Bart2000/StackCabinet/README.md

# StackCabinet
A modular component cabinet controlled by the touch of a finger
