Bart2000/StackCabinet/models/base/StackCabinet_Base_Main_Body_1X.3mf

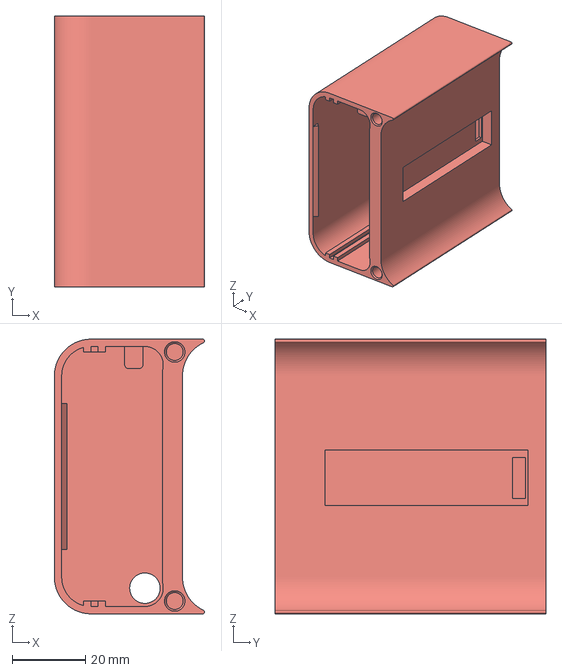
[picture p1: CAD file, 2023-01-27]
models/base/StackCabinet_Base_Main_Body_1X.3mf
41.0 x 74.0 x 75.0 mm
