Bart2000/StackCabinet/models/cabinet/StackCabinet_Main_Body_1X.3mf

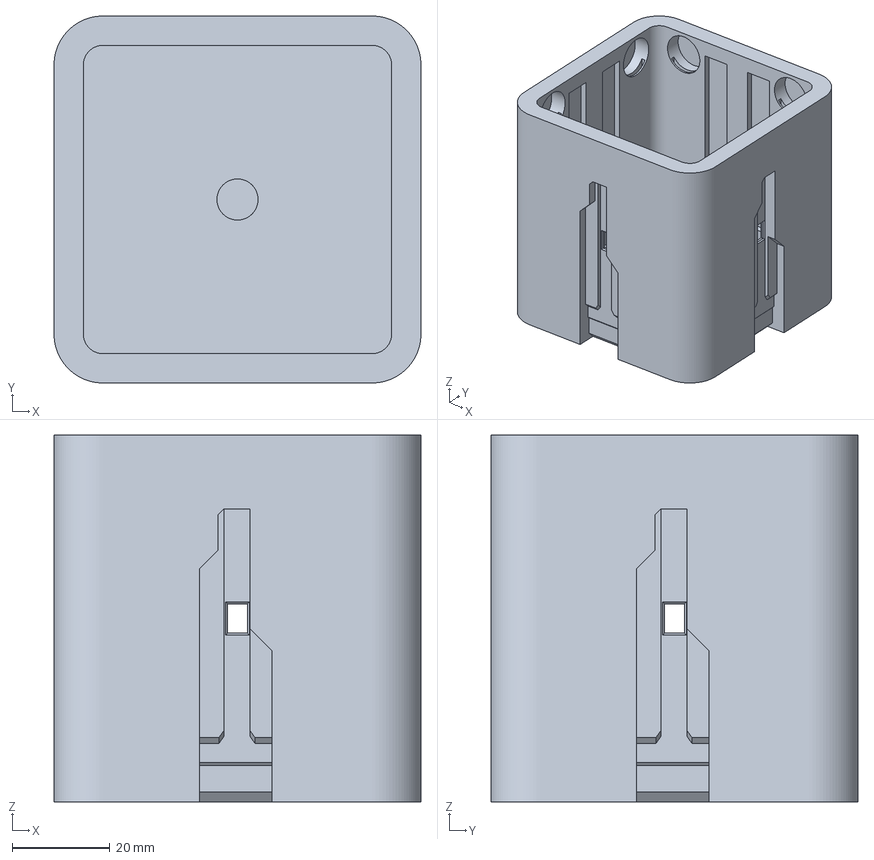
[picture p2: CAD file, 2023-01-27]
models/cabinet/StackCabinet_Main_Body_1X.3mf
75.0 x 75.0 x 75.0 mm
