Bart2000/StackCabinet/models/cabinet/StackCabinet_Main_Body_Hinge_Mount_1X.3mf

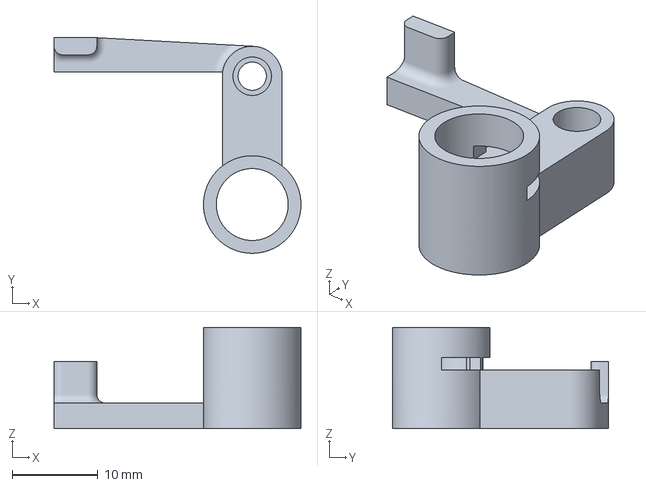
[picture p3: CAD file, 2023-01-23]
models/cabinet/StackCabinet_Main_Body_Hinge_Mount_1X.3mf
28.9 x 25.2 x 11.8 mm
