Bart2000/StackCabinet/models/base/StackCabinet_Base_Base_Magnet_retainer_2X.3mf

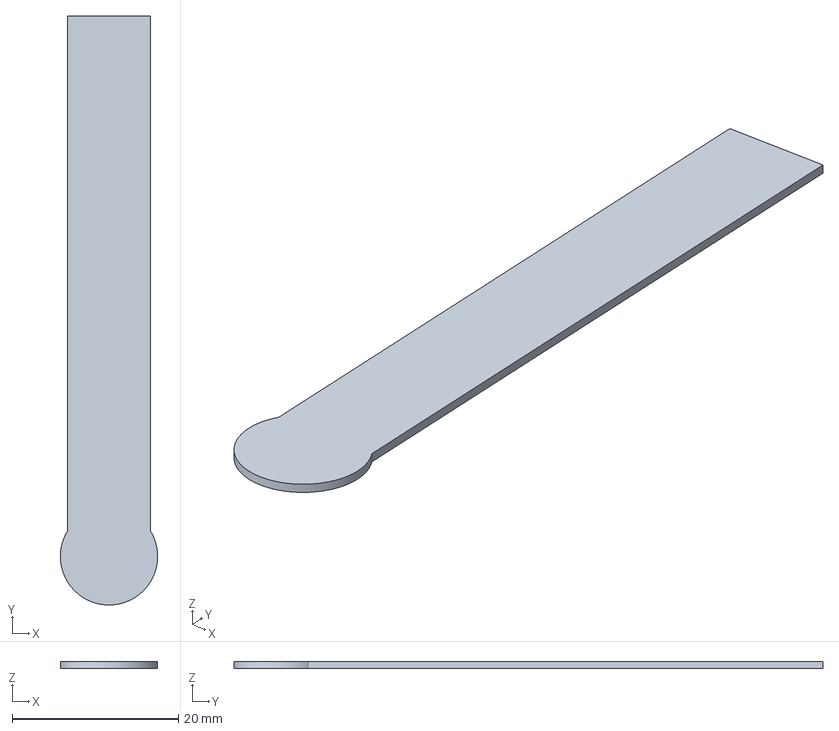
[picture p4: CAD file, 2023-01-23]
models/base/StackCabinet_Base_Base_Magnet_retainer_2X.3mf
11.7 x 70.8 x 0.8 mm
