Bart2000/StackCabinet/models/cabinet/StackCabinet_Magnet_Retainer_8X.3mf

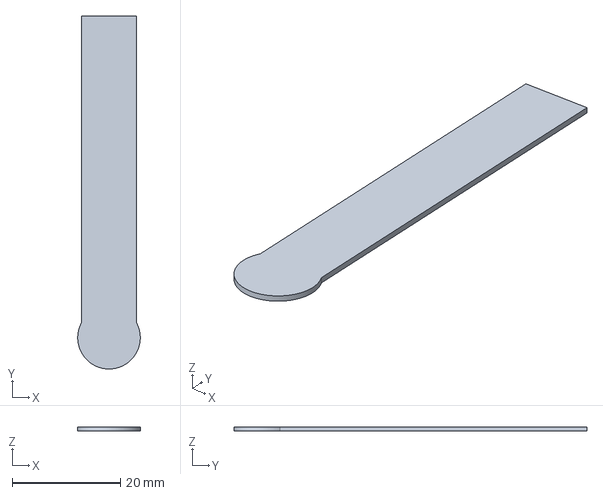
[picture p5: CAD file, 2023-01-23]
models/cabinet/StackCabinet_Magnet_Retainer_8X.3mf
11.6 x 65.3 x 0.8 mm
