Bart2000/StackCabinet/models/base/StackCabinet_Base_Lid_1X.3mf

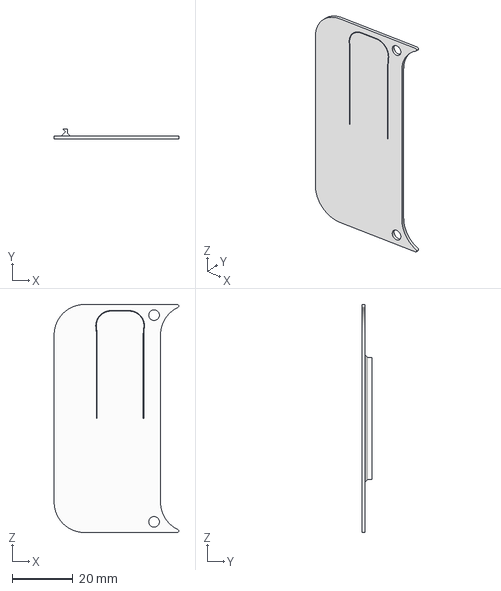
[picture p6: CAD file, 2023-01-23]
models/base/StackCabinet_Base_Lid_1X.3mf
41.0 x 3.39 x 75.0 mm
