Bart2000/StackCabinet/models/cabinet/StackCabinet_Drawer_P2_1X.3mf

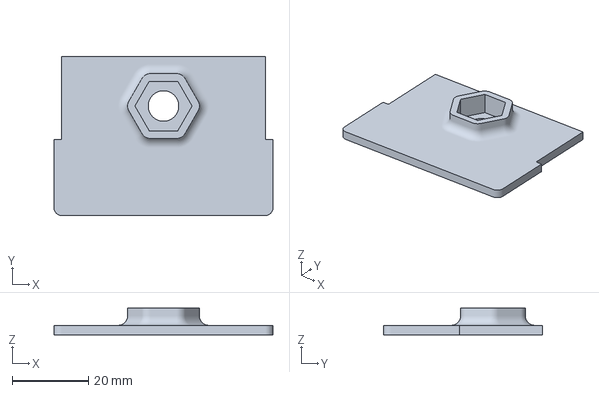
[picture p7: CAD file, 2023-01-23]
models/cabinet/StackCabinet_Drawer_P2_1X.3mf
57.5 x 41.8 x 7.00 mm
