Bart2000/StackCabinet/models/cabinet/StackCabinet_Drawer_P1_1X.3mf

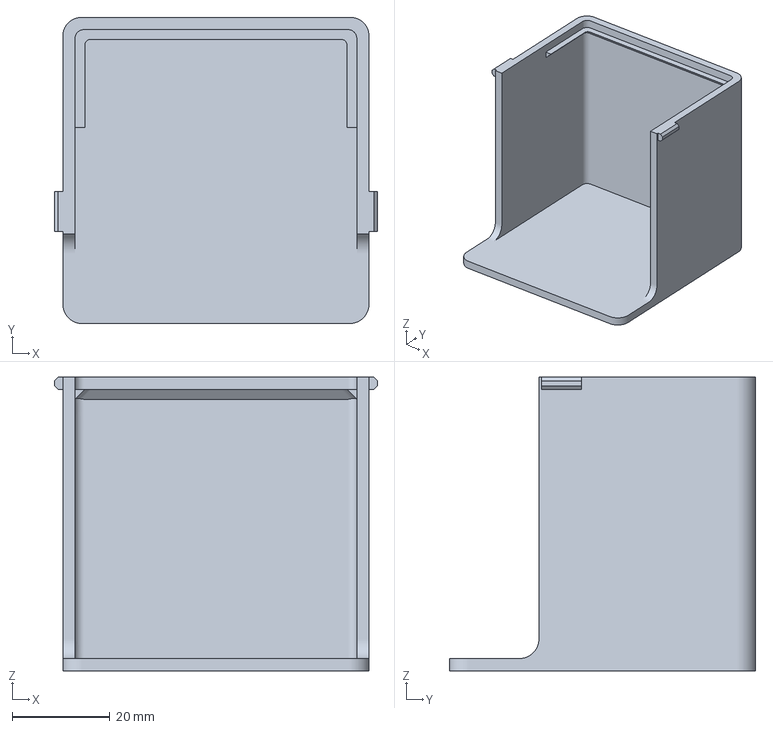
[picture p8: CAD file, 2023-01-23]
models/cabinet/StackCabinet_Drawer_P1_1X.3mf
66.0 x 62.6 x 60.0 mm
