Bart2000/StackCabinet/models/cabinet/StackCabinet_Backcover_1X.3mf

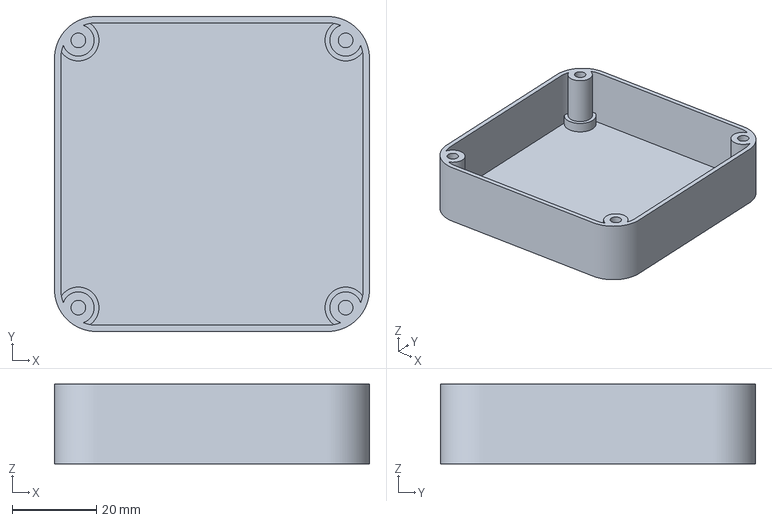
[picture p9: CAD file, 2023-01-23]
models/cabinet/StackCabinet_Backcover_1X.3mf
75.0 x 75.0 x 19.0 mm
