Bart2000/StackCabinet/models/cabinet/StackCabinet_Hinge_1X.3mf

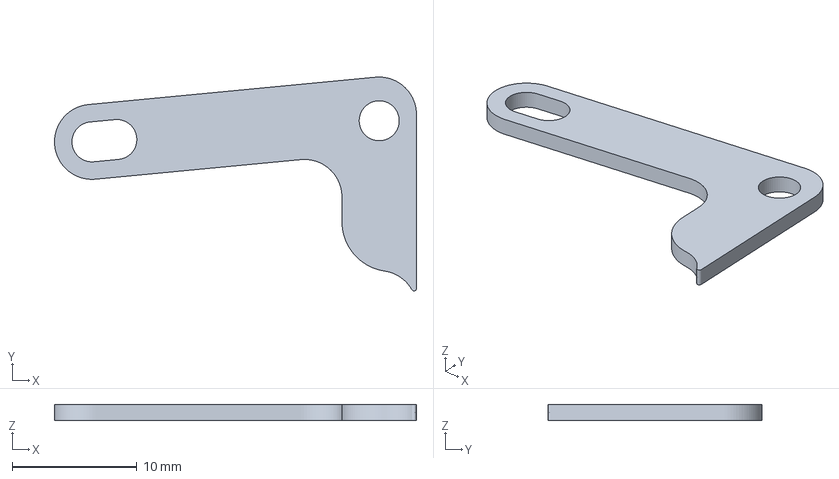
[picture p10: CAD file, 2023-01-23]
models/cabinet/StackCabinet_Hinge_1X.3mf
29.0 x 17.1 x 1.30 mm
