Bart2000/StackCabinet/(threads)

Thread 2 (2022-09-12):

SC_02 - As a user, I want to be able to connect the cabinet modulair

Krakert, 2022-09-12:
**DoD**
- [ ] Search for suitable spring fingers/contacts that we can use to develop a custom connector.
- [ ] Develop a small and simple PCB where the spring fingers/contacts can be mounted to.
- [ ] Develop a mating case where the PCB will sit in and be able to connect properly.

Thread 3 (2022-09-12):

SC_03 - As a developer, I want a prototyping PCB that demonstrates all the functionalities of the Cabinet PCB

Bart2000, 2022-09-12:
**DoD**
Making 3 individual prototyping PCBs to test all the complex hardware before making a final order.

- [x] Controls to actuate the solenoid
- [x] Switching regulator to step down the voltage to 24V and 5V
- [x] Transistor array for controlling the 12 LEDs

Krakert, 2022-09-29:
**Step Down Regulator**

* **Step-Down Voltage Regulator 48V -> 24V @ 1A (solenoid)**
   -  LM2576HVT - ADJ
* **Step-Down Voltage Regulator 24V -> 5V @ 1A (main electronic)**
(High voltage (> 40V) Step-Down Regulator are not commanly aviable, that why we will transform the 24V to 5V)
   - XL1509-5.0E1

Closed 2023-01-18.

Thread 6 (2022-10-12):

SC_06 - As a developer, I want to have a first cabinet PCB design done and orderd

Krakert, 2022-10-12:
**DoD**
- [x] Calculations done for step-down converters
- [x] Schematic
- [x] 2 layer PCB design that fits cabinet
- [x] Ordered (on completion of #3 )

Krakert, 2022-12-01:
@Bart2000 We can close this one, PCB's are ordered.

Closed 2023-01-18.

Thread 8 (2022-10-12):

SC_08 - As a user, I want to have an app that interfaces with the StackCabinet

Krakert, 2022-10-12:
**DoD**
- [x] Look into setting up a Bluetooth connection with Android devices and the ESP32
- [x] Build structure for the app
- [x] Setup code to connect to a ESP32
- [x] Send example data to and from the ESP

Krakert, 2022-12-01:
@Bart2000 I think, that we can close this issue, progress is going well with the app

Closed 2022-12-07.

Thread 11 (2022-12-12):

SC_09 - As a developer, I want to have a PCB for the base controller

Bart2000, 2022-12-12:
DoD:

- [x] PCB contains step down from 36V to 5V
- [x] PCB contains open drain circuit for half duplex communication
- [x] PCB contains level shifter for communication between 3.3V and 5V
- [x] PCB contains SCCP connector compliance

Closed 2023-01-23.

Thread 21 (2023-01-11):

SC_17 - As a user, I want to be able to search for a component in the app

Krakert, 2023-01-11:
DoD:

- [ ] Search button to start a search
- [ ] highlight the cabinet that contains the correct component
