Bart2000/StackCabinet/boards/base/base.kicad_pcb

## KiCad design boards/base/base.kicad_pcb (2023-01-23)

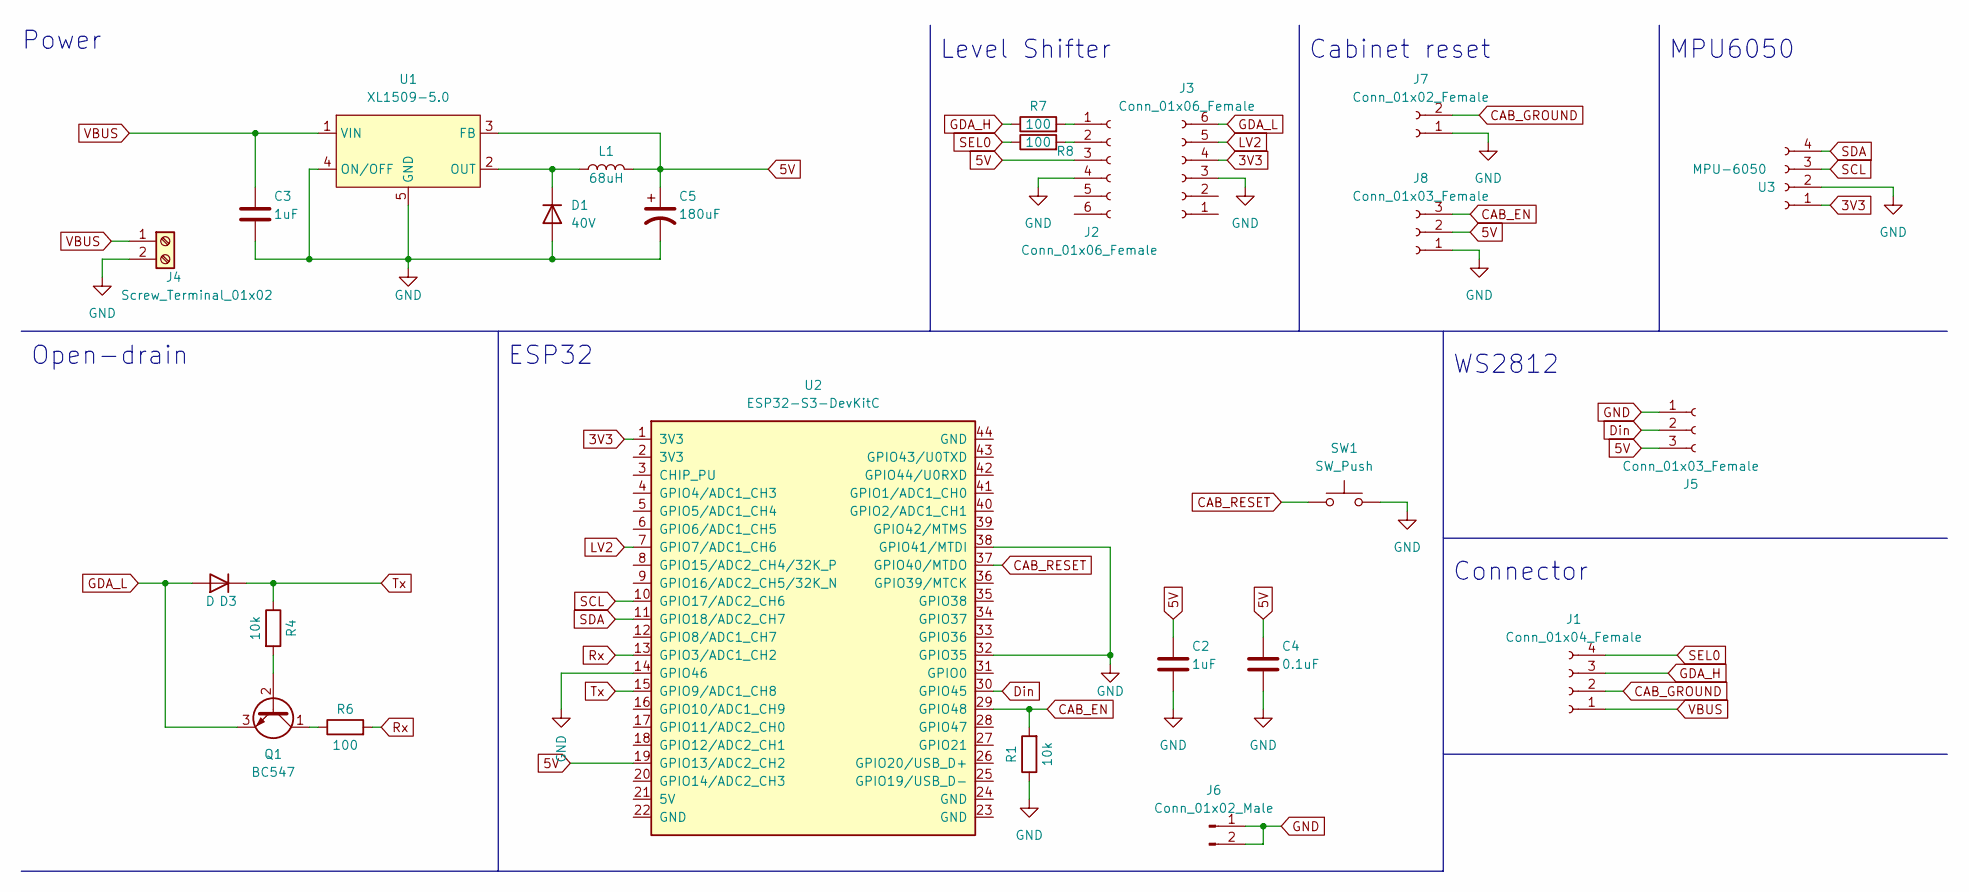
[picture p11: schematic base.kicad_sch]

Parts:
C2, C3: 1uF; C_0805_2012Metric; Mfr. Part# CC0805KKX7R9BB105; LCSC. Part# C91185
C4: 0.1uF; C_0805_2012Metric; Mfr. Part# C0805B104K500NT; LCSC. Part# C476766
C5: 180uF; CP_Radial_D8.0mm_P3.50mm; Mfr. Part# LKMD0901V181MF; LCSC. Part# C442870
D1: 40V; D_SOD-123; Mfr. Part# DSK34; LCSC. Part# C3015221
D3: D; R_Box_L8.4mm_W2.5mm_P5.08mm
J1: Conn_01x04_Female; PinHeader_1x04_P2.54mm_Vertical
J2, J3: Conn_01x06_Female; PinHeader_1x06_P2.54mm_Vertical
J4: Screw_Terminal_01x02; Altech_AK300_1x02_P5.00mm_45-Degree
J5, J8: Conn_01x03_Female; PinHeader_1x03_P2.54mm_Vertical
J6: Conn_01x02_Male; TerminalBlock_Altech_AK300-2_P5.00mm
J7: Conn_01x02_Female; Altech_AK300_1x02_P5.00mm_45-Degree
L1: 68uH; L_6.3x6.3_H3; Mfr. Part# CYA0650-68UH; LCSC. Part# C5189964
Q1: BC547; TO-92_Inline
R1, R4: 10k; R_Axial_DIN0207_L6.3mm_D2.5mm_P5.08mm_Vertical
R6, R7, R8: 100; R_Axial_DIN0207_L6.3mm_D2.5mm_P5.08mm_Vertical
SW1: SW_Push; PinHeader_1x02_P2.54mm_Vertical
U1: XL1509-5.0; XLE1509; Mfr. Part# XL1509-5.0E1; LCSC. Part# C61063
U2: ESP32-S3-DevKitC; ESP32-DevKitC
U3: MPU-6050; PinHeader_1x04_P2.54mm_Vertical

Connections:
3V3: J3.4, U2.1 (3V3), U3.1
5V: C2.1, C4.1, C5.1, J2.3, J5.3, J8.2, L1.2, U1.3 (FB), U2.19 (GPIO13/ADC2_CH2)
CAB_EN: J8.3, R1.2, U2.29 (GPIO48)
CAB_GROUND: J1.2, J7.2
CAB_RESET: SW1.1, U2.37 (GPIO40/MTDO)
Din: J5.2, U2.30 (GPIO45)
GDA_H: J1.3, R7.1
GDA_L: D3.2 (A), J3.6, Q1.3 (E)
GND: C2.2, C3.2, C4.2, C5.2, D1.2 (A), J2.4, J3.3, J4.2, J5.1, J6.1, J6.2, J7.1, J8.1, R1.1, SW1.2, U1.4 (ON/OFF), U1.5 (GND), U2.14 (GPIO46), U2.32 (GPIO35), U2.38 (GPIO41/MTDI), U3.2
LV2: J3.5, U2.7 (GPIO7/ADC1_CH6)
unnamed: D1.1 (K), L1.1, U1.2 (OUT)
unnamed: J2.1, R7.2
unnamed: J2.2, R8.2
unnamed: Q1.1 (C), R6.1
unnamed: Q1.2 (B), R4.2
Rx: R6.2, U2.13 (GPIO3/ADC1_CH2)
SCL: U2.10 (GPIO17/ADC2_CH6), U3.3
SDA: U2.11 (GPIO18/ADC2_CH7), U3.4
SEL0: J1.4, R8.1
Tx: D3.1 (K), R4.1, U2.15 (GPIO9/ADC1_CH8)
VBUS: C3.1, J1.1, J4.1, U1.1 (VIN)

Notes on the sheet:
ESP32
WS2812
Power
Open-drain
Level Shifter
Connector
Cabinet reset
MPU6050

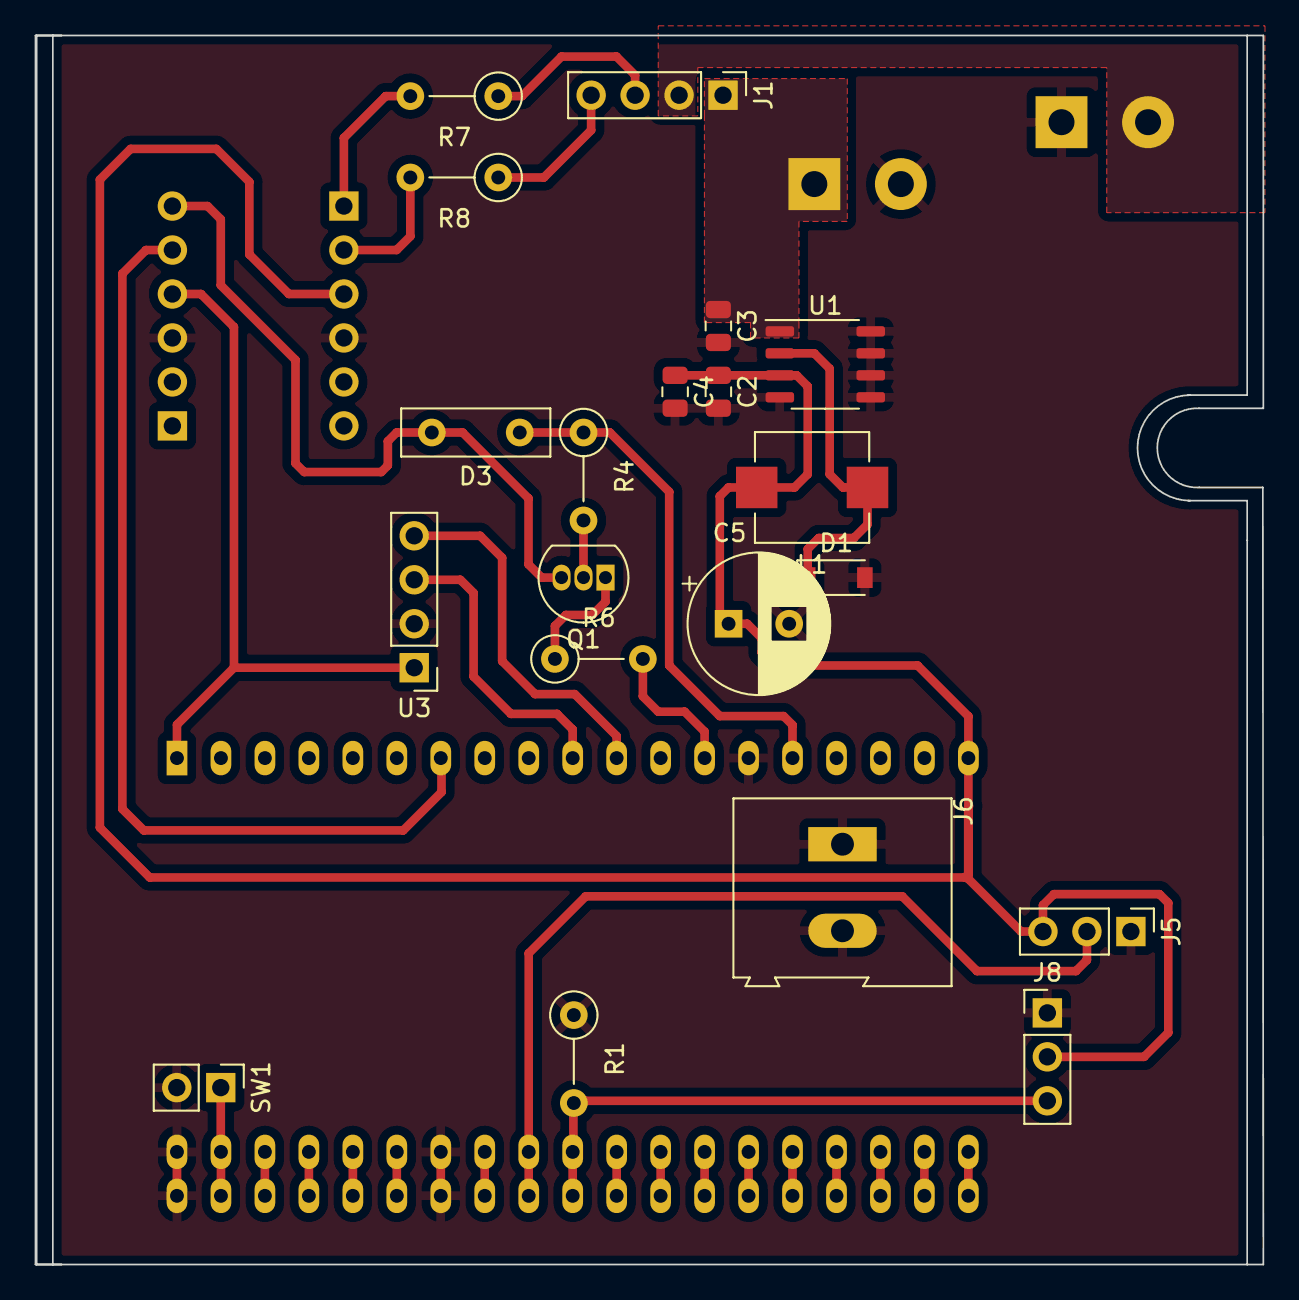
[picture p12: board base.kicad_pcb from above]

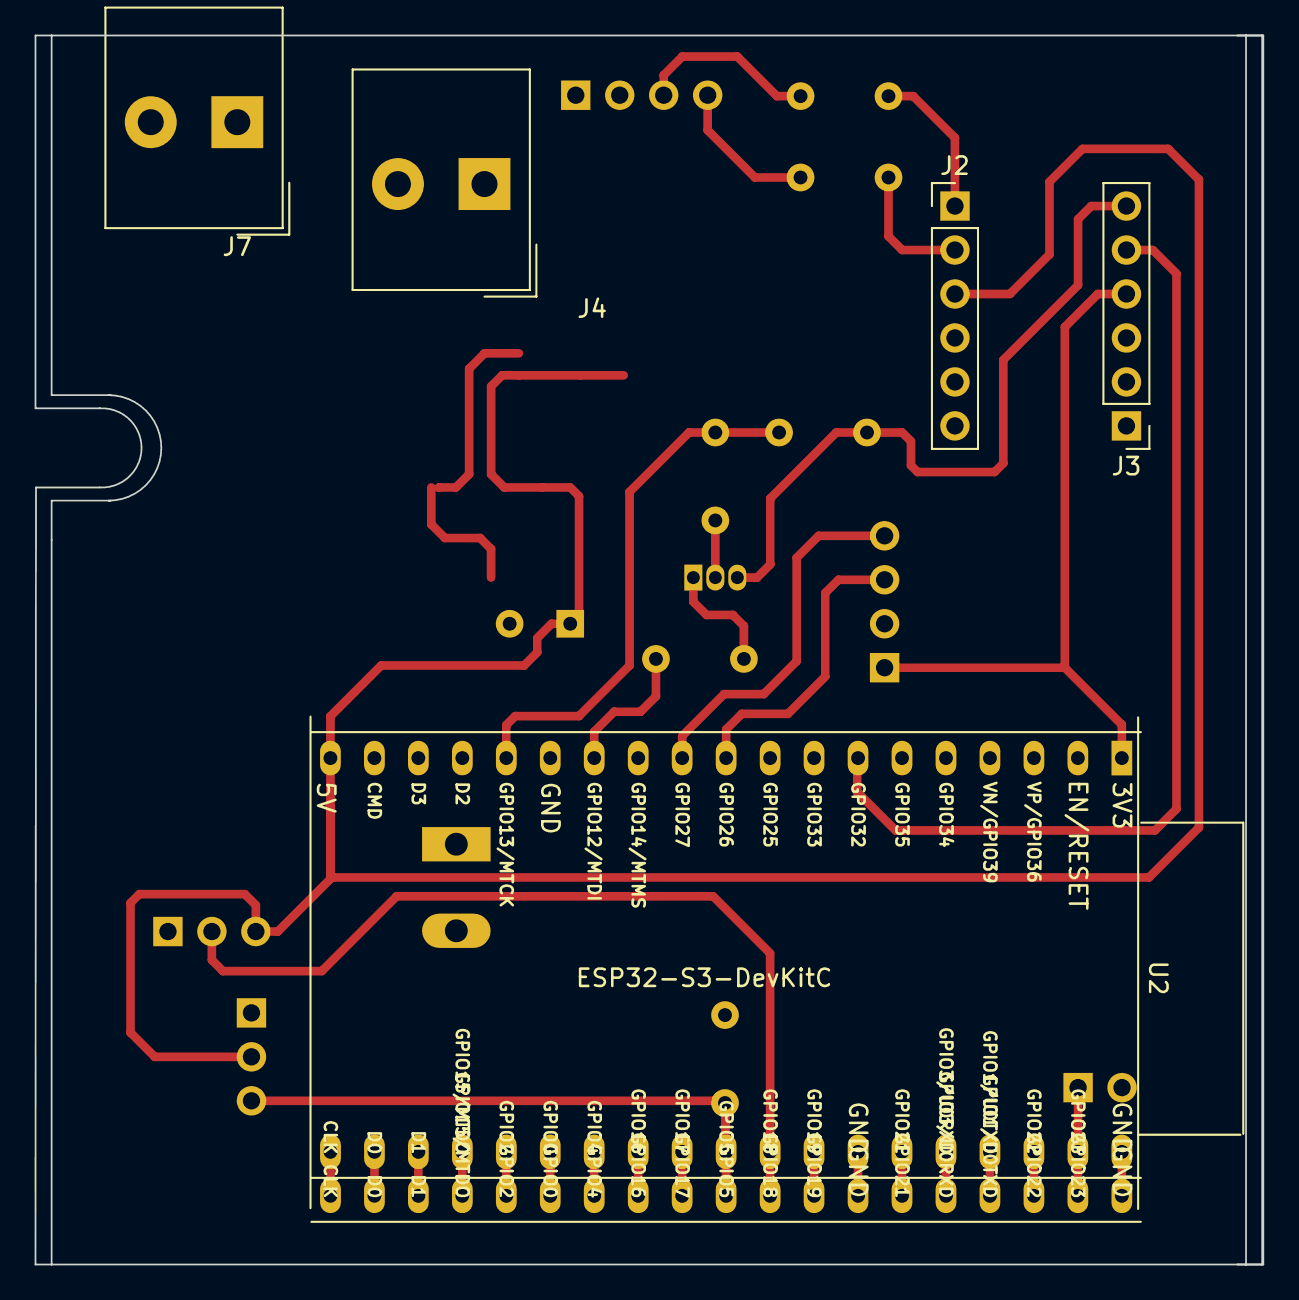
[picture p13: board base.kicad_pcb from below]

Board: 2 copper layers, 70.9 x 71.0 mm, 25 parts (5 on the bottom side), 21 nets.
