Bart2000/StackCabinet/boards/cab/cab.kicad_pcb

## KiCad design boards/cab/cab.kicad_pcb (2023-01-23)

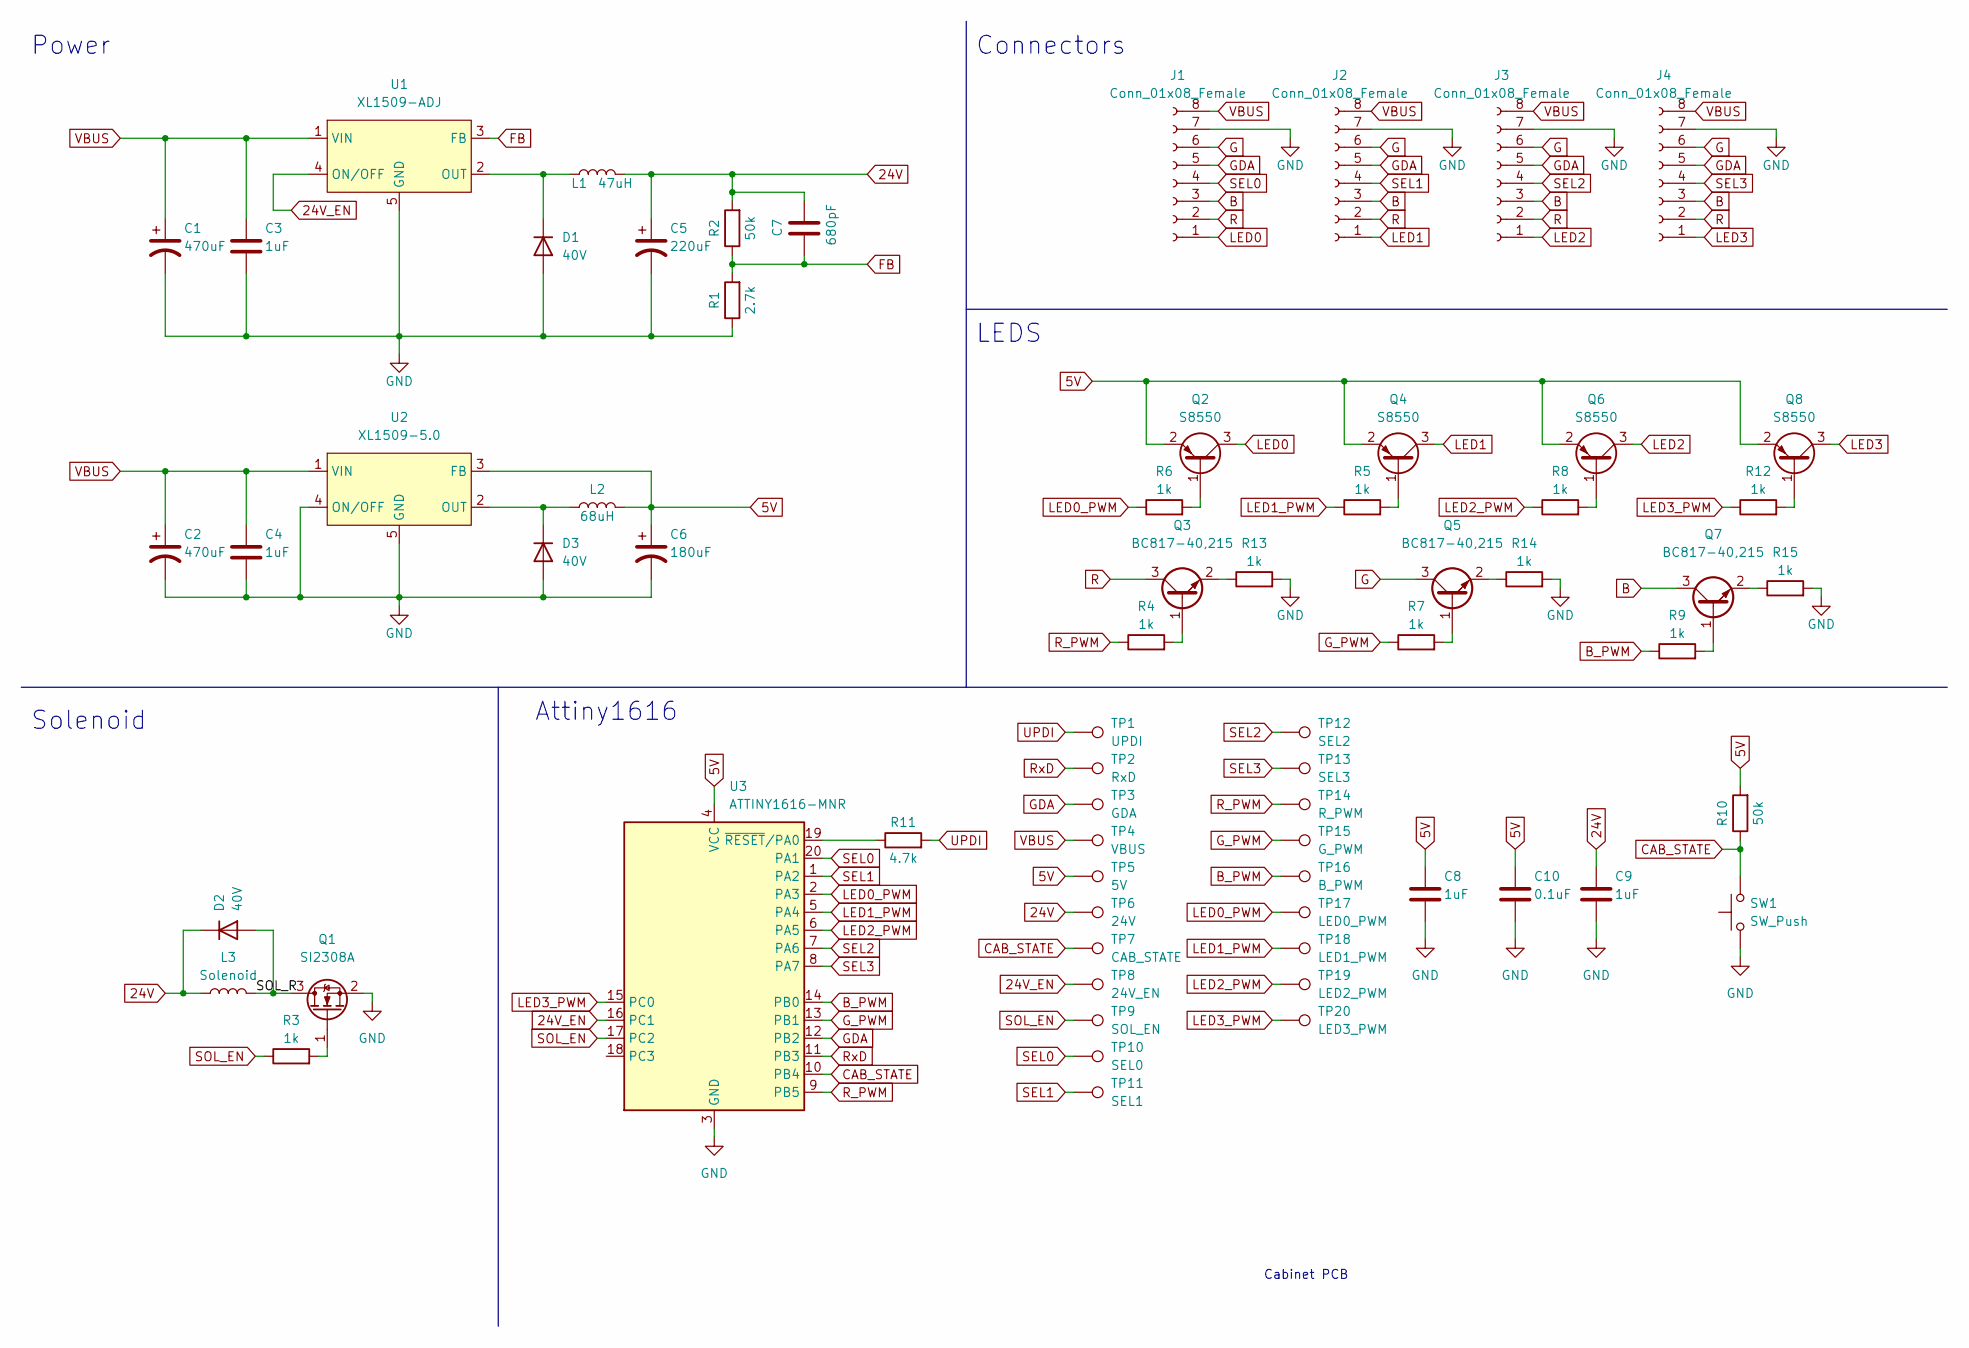
[picture p14: schematic cab.kicad_sch]

Parts:
C1, C2: 470uF; C_Radial_D12.5mm_H20.0mm_P5.00mm; Mfr. Part# OGPL41H471MF; LCSC. Part# C269945
C3, C4, C8, C9: 1uF; C_0805_2012Metric; Mfr. Part# CC0805KKX7R9BB105; LCSC. Part# C91185
C5: 220uF; CP_Radial_D8.0mm_P3.50mm; Mfr. Part# ECR1VBK221MLL080011; LCSC. Part# C221302
C6: 180uF; CP_Radial_D8.0mm_P3.50mm; Mfr. Part# LKMD0901V181MF; LCSC. Part# C442870
C7: 680pF; C_0805_2012Metric; Mfr. Part# 0805B681K500CT; LCSC. Part# C152864
C10: 0.1uF; C_0805_2012Metric; Mfr. Part# C0805B104K500NT; LCSC. Part# C476766
D1, D2, D3: 40V; D_SOD-123; Mfr. Part# DSK34; LCSC. Part# C3015221
J1, J2, J3, J4: Conn_01x08_Female; PinHeader_1x08_P1.27mm_Vertical; Mfr. Part# C691120; LCSC. Part# C691120
L1: 47uH; YNR1050-470M; Mfr. Part# YNR1050-470M; LCSC. Part# C5142143
L2: 68uH; L_6.3x6.3_H3; Mfr. Part# CYA0650-68UH; LCSC. Part# C5189964
L3: Solenoid; TerminalBlock_4Ucon_1x02_P3.50mm_Vertical; Mfr. Part# KF350-3.5-2P; LCSC. Part# C474892
Q1: SI2308A; SOT-23; Mfr. Part# SI2308A; LCSC. Part# C347491
Q2, Q4, Q6, Q8: S8550; SOT-23; Mfr. Part# S8550; LCSC. Part# C181159
Q3, Q5, Q7: BC817-40,215; SOT-23; Mfr. Part# BC817-40,215; LCSC. Part# C52801
R1: 2.7k; R_0805_2012Metric; Mfr. Part# ARG05FTC2701; LCSC. Part# C218493
R2, R10: 50k; R_0805_2012Metric; Mfr. Part# ARG05DTC5002; LCSC. Part# C2828840
R3, R4, R5, R6, R7, R8, R9, R12, R13, R14, R15: 1k; R_0805_2012Metric; Mfr. Part# SWR05JTEV1001; LCSC. Part# C412430
R11: 4.7k; R_0805_2012Metric; Mfr. Part# RS-05K472JT; LCSC. Part# C115310
SW1: SW_Push; PinHeader_1x02_P2.54mm_Vertical; Mfr. Part# B3F-1005; LCSC. Part# C397293
TP1: UPDI; testpad
TP2: RxD; testpad
TP3: GDA; testpad
TP4: VBUS; testpad
TP5: 5V; testpad
TP6: 24V; testpad
TP7: CAB_STATE; testpad
TP8: 24V_EN; testpad
TP9: SOL_EN; testpad
TP10: SEL0; testpad
TP11: SEL1; testpad
TP12: SEL2; testpad
TP13: SEL3; testpad
TP14: R_PWM; testpad
TP15: G_PWM; testpad
TP16: B_PWM; testpad
TP17: LED0_PWM; testpad
TP18: LED1_PWM; testpad
TP19: LED2_PWM; testpad
TP20: LED3_PWM; testpad
U1: XL1509-ADJ; XLE1509; Mfr. Part# XL1509-ADJE1; LCSC. Part# C74192
U2: XL1509-5.0; XLE1509; Mfr. Part# XL1509-5.0E1; LCSC. Part# C61063
U3: ATTINY1616-MNR; VQFN-20-1EP_3x3mm_P0.4mm_EP1.7x1.7mm; Mfr. Part# ATTINY1616-MNR; LCSC. Part# C507118

Connections:
5V: C6.1, C8.1, C10.1, L2.2, Q2.2 (E), Q4.2 (E), Q6.2 (E), Q8.2 (E), R10.2, TP5.1, U2.3 (FB), U3.4 (VCC)
24V: C5.1, C7.1, C9.1, D2.1 (K), L1.2, L3.1, R2.2, TP6.1
24V_EN: TP8.1, U1.4 (ON/OFF), U3.16 (PC1)
/SOL_R: D2.2 (A), L3.2, Q1.3 (D)
B: J1.3, J2.3, J3.3, J4.3, Q7.3 (C)
B_PWM: R9.1, TP16.1, U3.14 (PB0)
CAB_STATE: R10.1, SW1.2, TP7.1, U3.10 (PB4)
FB: C7.2, R1.2, R2.1, U1.3 (FB)
G: J1.6, J2.6, J3.6, J4.6, Q5.3 (C)
GDA: J1.5, J2.5, J3.5, J4.5, TP3.1, U3.12 (PB2)
GND: C1.2, C2.2, C3.2, C4.2, C5.2, C6.2, C8.2, C9.2, C10.2, D1.2 (A), D3.2 (A), J1.7, J2.7, J3.7, J4.7, Q1.2 (S), R1.1, R13.2, R14.2, R15.2, SW1.1, U1.5 (GND), U2.4 (ON/OFF), U2.5 (GND), U3.3 (GND), U3.21 (GND)
G_PWM: R7.1, TP15.1, U3.13 (PB1)
LED0: J1.1, Q2.3 (C)
LED0_PWM: R6.1, TP17.1, U3.2 (PA3)
LED1: J2.1, Q4.3 (C)
LED1_PWM: R5.1, TP18.1, U3.5 (PA4)
LED2: J3.1, Q6.3 (C)
LED2_PWM: R8.1, TP19.1, U3.6 (PA5)
LED3: J4.1, Q8.3 (C)
LED3_PWM: R12.1, TP20.1, U3.15 (PC0)
unnamed: D1.1 (K), L1.1, U1.2 (OUT)
unnamed: D3.1 (K), L2.1, U2.2 (OUT)
unnamed: Q1.1 (G), R3.2
unnamed: Q2.1 (B), R6.2
unnamed: Q3.1 (B), R4.2
unnamed: Q3.2 (E), R13.1
unnamed: Q4.1 (B), R5.2
unnamed: Q5.1 (B), R7.2
unnamed: Q5.2 (E), R14.1
unnamed: Q6.1 (B), R8.2
unnamed: Q7.1 (B), R9.2
unnamed: Q7.2 (E), R15.1
unnamed: Q8.1 (B), R12.2
unnamed: R11.1, U3.19 (~RESET/PA0)
R: J1.2, J2.2, J3.2, J4.2, Q3.3 (C)
R_PWM: R4.1, TP14.1, U3.9 (PB5)
RxD: TP2.1, U3.11 (PB3)
SEL0: J1.4, TP10.1, U3.20 (PA1)
SEL1: J2.4, TP11.1, U3.1 (PA2)
SEL2: J3.4, TP12.1, U3.7 (PA6)
SEL3: J4.4, TP13.1, U3.8 (PA7)
SOL_EN: R3.1, TP9.1, U3.17 (PC2)
UPDI: R11.2, TP1.1
VBUS: C1.1, C2.1, C3.1, C4.1, J1.8, J2.8, J3.8, J4.8, TP4.1, U1.1 (VIN), U2.1 (VIN)

Notes on the sheet:
LEDS
Connectors
Cabinet PCB
Power
Solenoid
Attiny1616

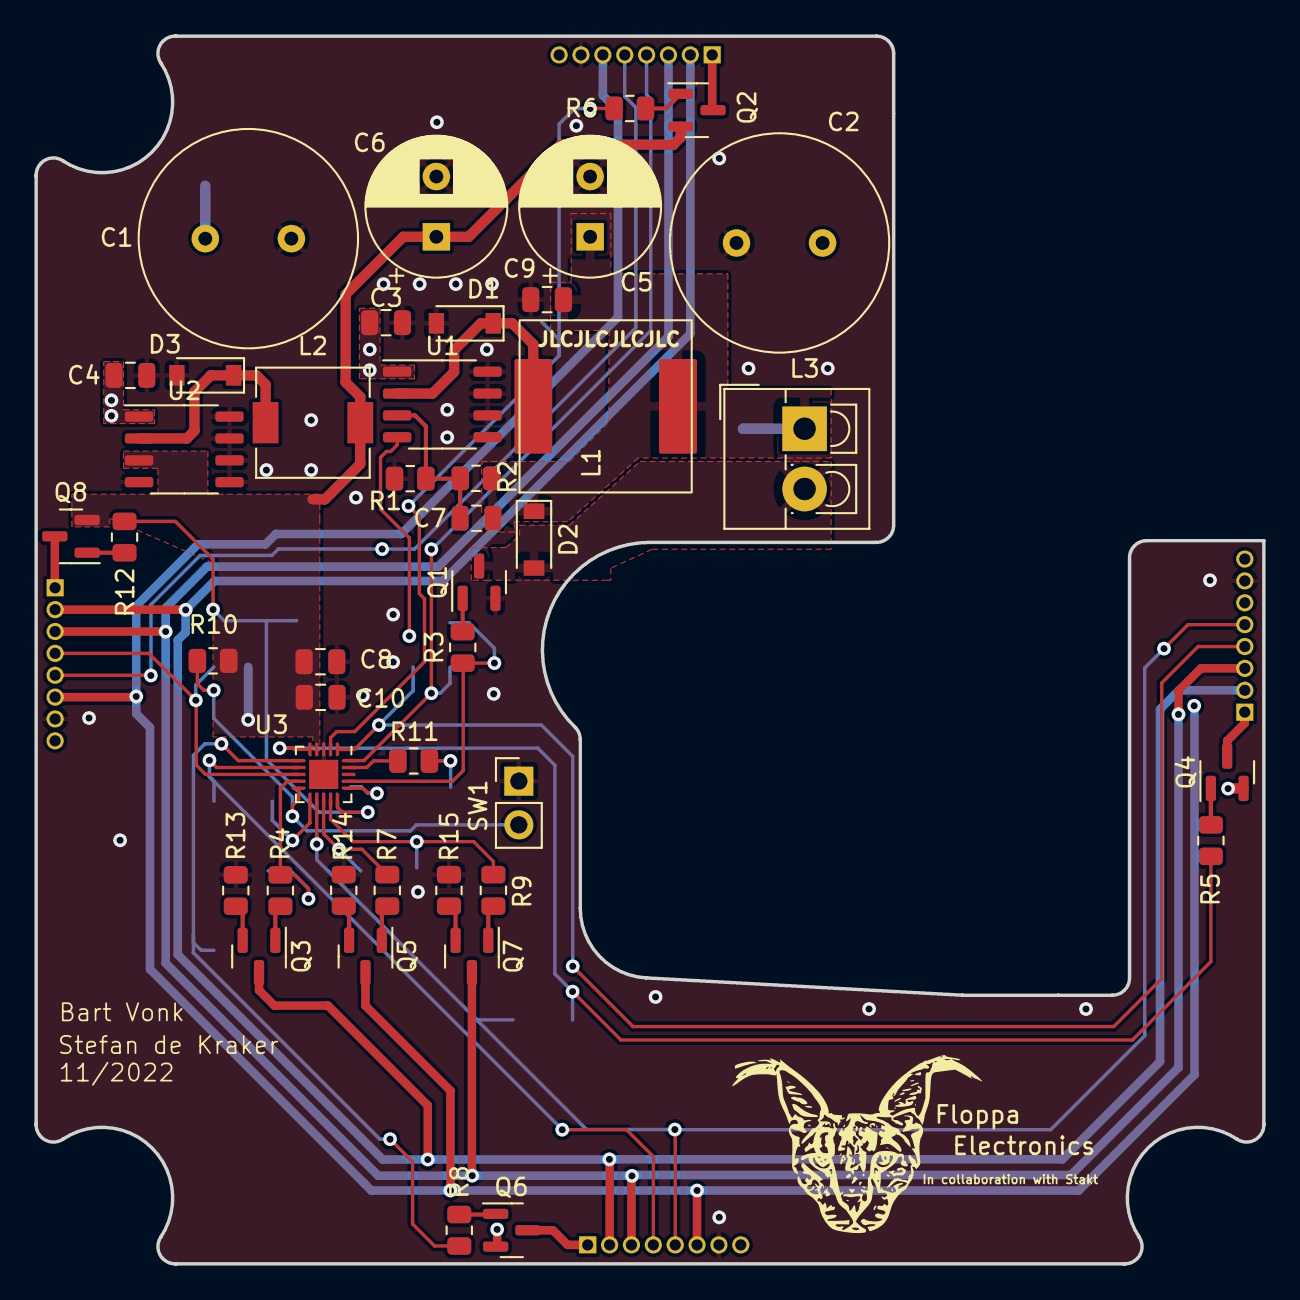
[picture p15: board cab.kicad_pcb from above]

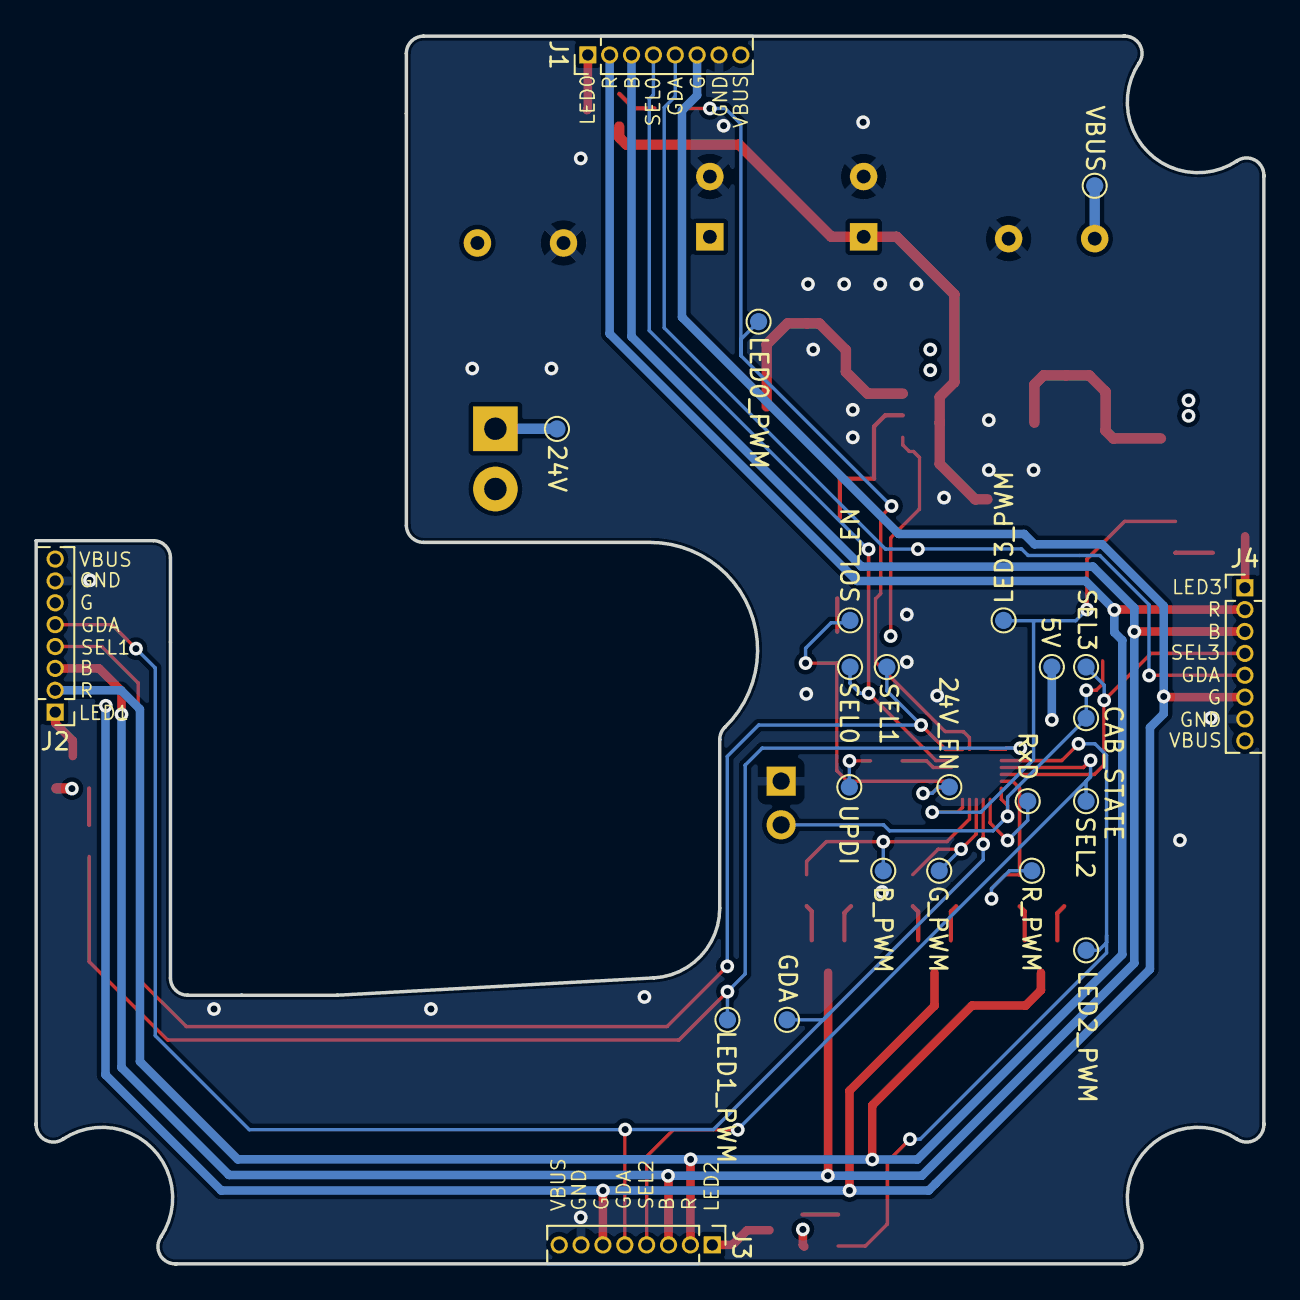
[picture p16: board cab.kicad_pcb from below]

Board: 4 copper layers, 71.3 x 71.3 mm, 67 parts (4 on the bottom side), 44 nets.
