Bart2000/StackCabinet/(commit log)

2022-10-03 Added print example
2022-10-09 ESP32 test
2022-10-10 Added RXC receive interrupt and baudrate error correction
    [main.cpp]
2022-10-10 Added simple esp32 sketch
2022-10-13 Initialized KiCad schematic
    [cab.kicad_pcb, cab.kicad_sch]
2022-10-14 Added power schematic
    [cab.kicad_sch, power.kicad_sch]
2022-10-17 Removed hierarchy and added Connectors, Leds
    [attiny1616.kicad_sch, cab.kicad_sch, connectors.kicad_sch, power.kicad_sch]
2022-10-24 Updated schematic
    [cab.kicad_pcb]
2022-10-28 Created PCB
    [cab.kicad_pcb, cab.kicad_sch]
2022-10-29 Finished schematic
    [cab.csv, cab.kicad_sch]
2022-10-29 Reworked board outline
    [cab.kicad_pcb]
2022-10-29 Fixed mosfet footprint
    [cab.kicad_pcb, cab.kicad_sch]
2022-10-29 Placed Power, Attiny and LED power
    [cab.kicad_pcb, cab.kicad_sch]
2022-11-13 Routing & planes
    [cab.kicad_pcb, cab.kicad_sch]
2022-11-13 Tuned polygons
    [cab.kicad_pcb]
2022-11-14 Convert to 4 layer
    [cab-backup.kicad_pcb, cab.kicad_pcb, cab.kicad_sch]
2022-11-15 Added vias
    [cab.kicad_pcb]
2022-11-16 Setup permissions, search for bluetooth devices, and pair to selected devices.
2022-11-17 Added connect and connected Threads, these Threads are used to, 1. setup a connection with a Bluetooth devices, and 2. to open a Input and Output stream to send and receive data
2022-11-17 Simple setup of the Grid compose view and ViewModel, implements the new Threads in the repository to send and receive data from a bluetooth device
2022-11-20 Added LED resistors, changed routing
    [cab.kicad_pcb, cab.kicad_sch]
2022-11-20 Created ESP32 SCCP wrapper and started identification
2022-11-21 Added silklayer text and generated gerber
    [cab.kicad_pcb, cab.kicad_sch]
2022-11-22 esp32 identification
2022-11-23 Made SCCP wrapper for esp32
2022-12-04 Identification switched to port A
2022-12-13 Started BasePCB
    [base.kicad_pcb, base.kicad_sch]
2022-12-19 Finished BasePCB
    [base.kicad_pcb, base.kicad_sch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]
2022-12-23 Added cab_reset and base LED
    [base.kicad_sch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]
2022-12-23 Added led_strip
2022-12-23 Final version of BasePCB
    [base.kicad_pcb, base.kicad_sch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]
2023-01-10 Added diode on base
    [base.kicad_pcb, base.kicad_sch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]
2023-01-11 Made RGB leds for 3 strip
2023-01-12 Added reset button detect
2023-01-13 Tidied Base PCB
    [base.kicad_sch]
2023-01-17 Added the led_strip lib to the cmake file
2023-01-19 Base V2
    [base.kicad_pcb, base.kicad_sch]
2023-01-20 Changed routing
    [base-B_Cu.gbr, base-Edge_Cuts.gbr, base-F_Cu.gbr, base-NPTH.drl, base-PTH.drl, base-job.gbrjob]
2023-01-23 added 3D models, and roll back to ESP-IDF 4.4.2
    [StackCabinet_Backcover_1X.3mf, StackCabinet_Base_Base_Magnet_retainer_2X.3mf, StackCabinet_Base_Lid_1X.3mf, StackCabinet_Base_Main_Body_1X.3mf, StackCabinet_Drawer_P1_1X.3mf, StackCabinet_Drawer_P2_1X.3mf, StackCabinet_Hinge_1X.3mf, StackCabinet_Magnet_Retainer_8X.3mf]
2023-01-23 cleanup back-ups
    [base.kicad_pcb, base.kicad_sch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]
2023-01-27 Fixed bluetooth, and added LED status
    [main.cpp]
2023-01-27 Fixed design
    [StackCabinet_Base_Main_Body_1X.3mf, StackCabinet_Main_Body_1X.3mf]
